slash128v6/DC31_CNet_Badge/Docs/Photos/IMG_1198.jpeg

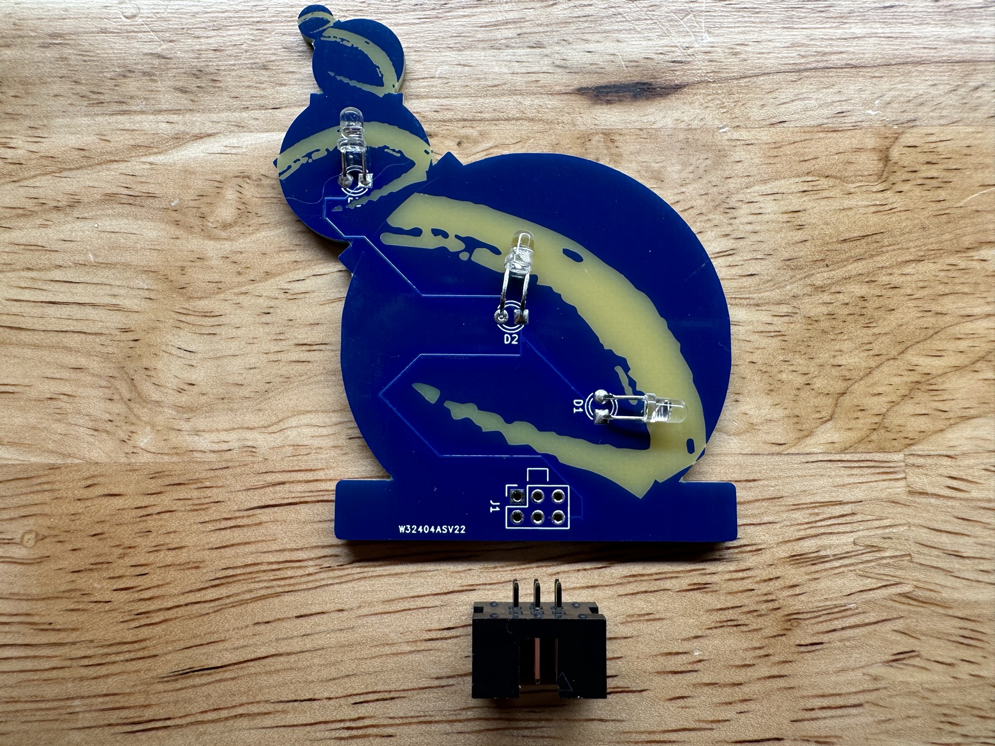
Docs/Photos/IMG_1198.jpeg
