slash128v6/DC31_CNet_Badge/Docs/Photos/Screenshot 2023-03-08 080836.png

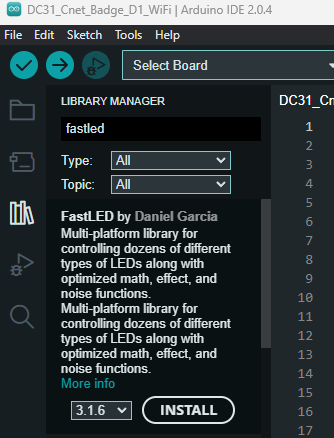
Docs/Photos/Screenshot 2023-03-08 080836.png
