slash128v6/DC31_CNet_Badge/Software/Wemos D1 Mini Info/Wemos Board Settings.png

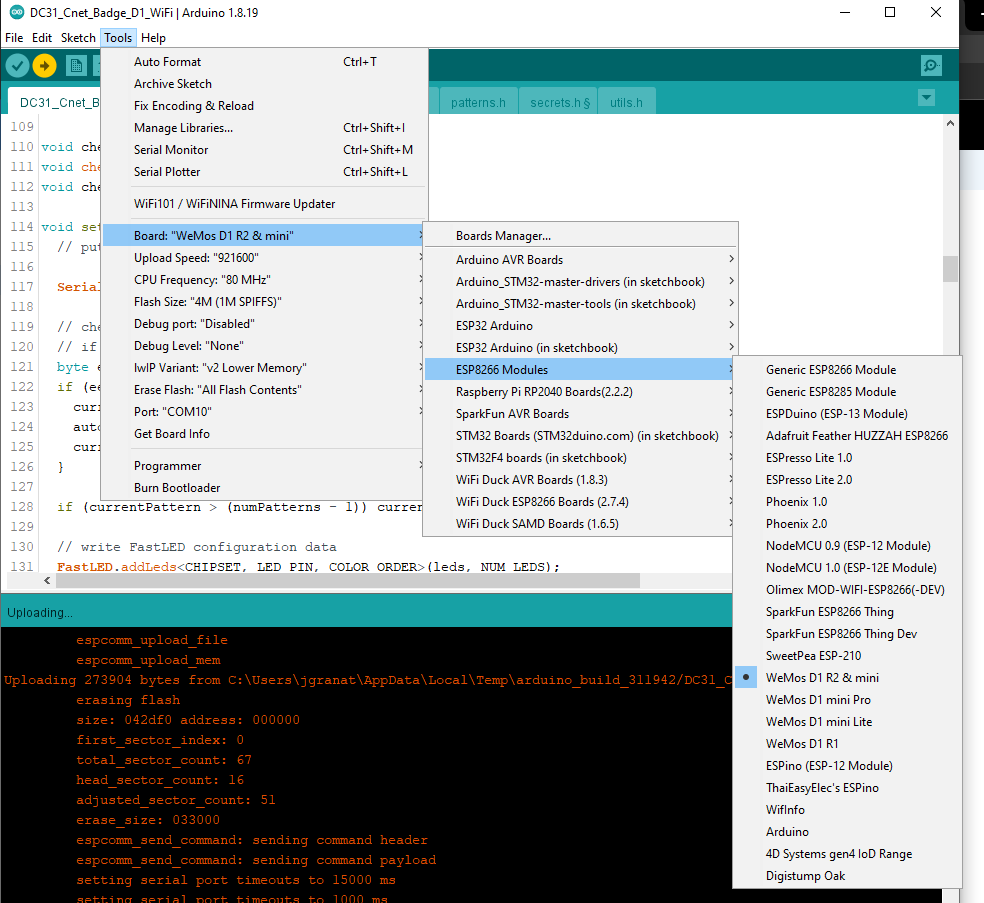
Software/Wemos D1 Mini Info/Wemos Board Settings.png
