slash128v6/DC31_CNet_Badge/Hardware/PCB Ordering Notes.txt

PCBWay.com Ordering

Front - 
0.8mm thickness
Blue soldermask
No silkscreen
No drills
No PCB ID

Rear - 
1.6mm thickness
Matte Black
No PCB ID
