slash128v6/DC31_CNet_Badge/Hardware/DC31_Cnet_Badge_Display_Stand/DC31_Cnet_Badge_Display_Stand-Body.stl

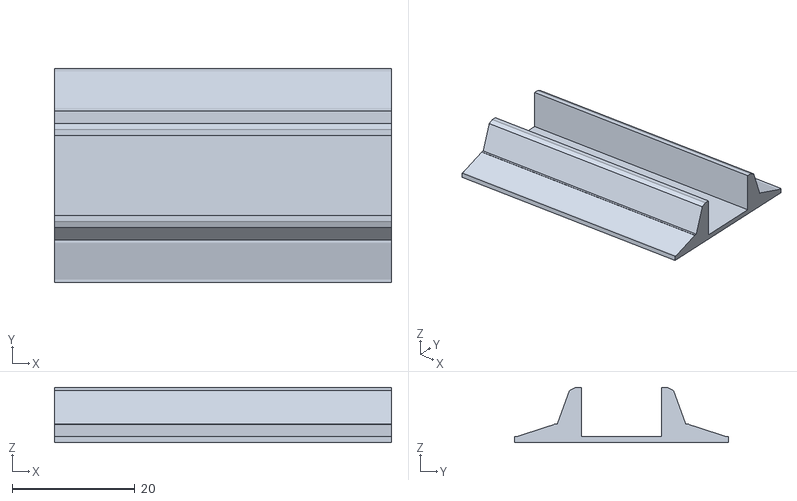
[picture p30: CAD file, 2023-06-28]
Hardware/DC31_Cnet_Badge_Display_Stand/DC31_Cnet_Badge_Display_Stand-Body.stl
55.0 x 35.0 x 9.00
