slash128v6/DC31_CNet_Badge/(list of files, cad)

Other CAD files:
Hardware/DC31_Cnet_Badge_Display_Stand/DC31_Cnet_Badge_Display_Stand.FCStd
Hardware/DC31_Cnet_Badge_Display_Stand/DC31_Cnet_Badge_Display_Stand.blend
