slash128v6/DC31_CNet_Badge/Software/Wemos D1 Mini Info/Wemos D1 Mini Pin Usage.png

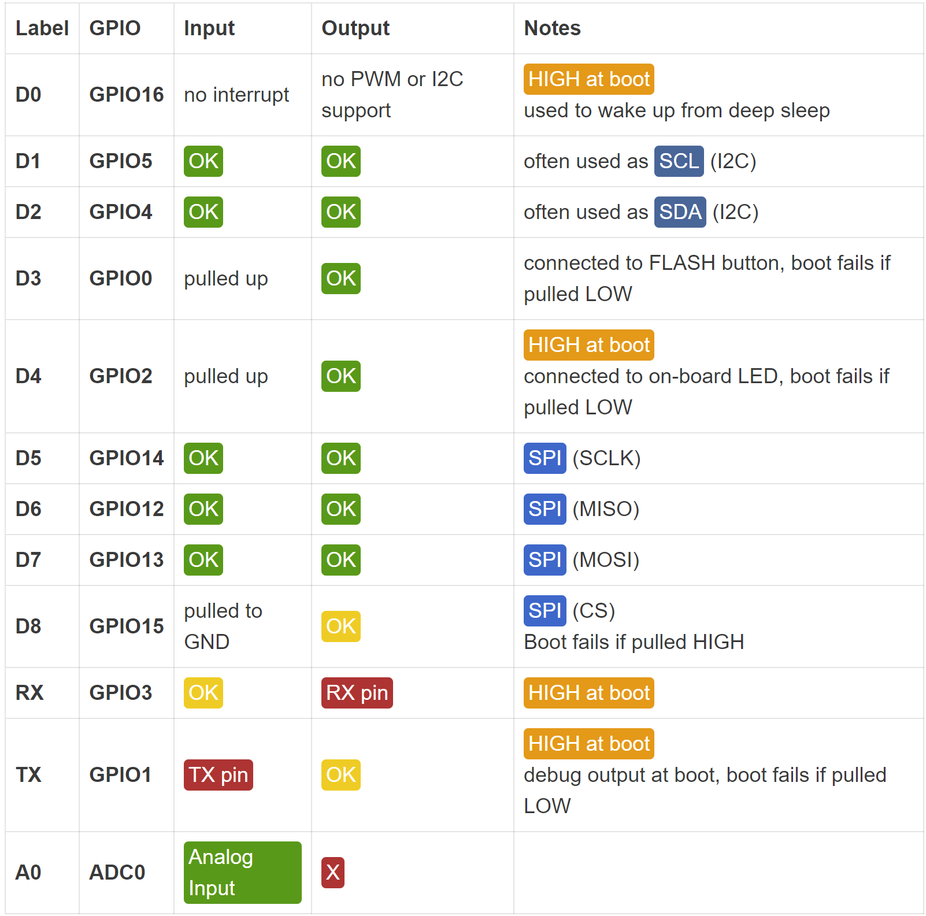
Software/Wemos D1 Mini Info/Wemos D1 Mini Pin Usage.png
