slash128v6/DC31_CNet_Badge/Hardware/DC31_Cnet_Badge_SAO/DC31_Cnet_Badge_SAO.kicad_pcb

## KiCad design Hardware/DC31_Cnet_Badge_SAO/DC31_Cnet_Badge_SAO.kicad_pcb (2023-06-05)

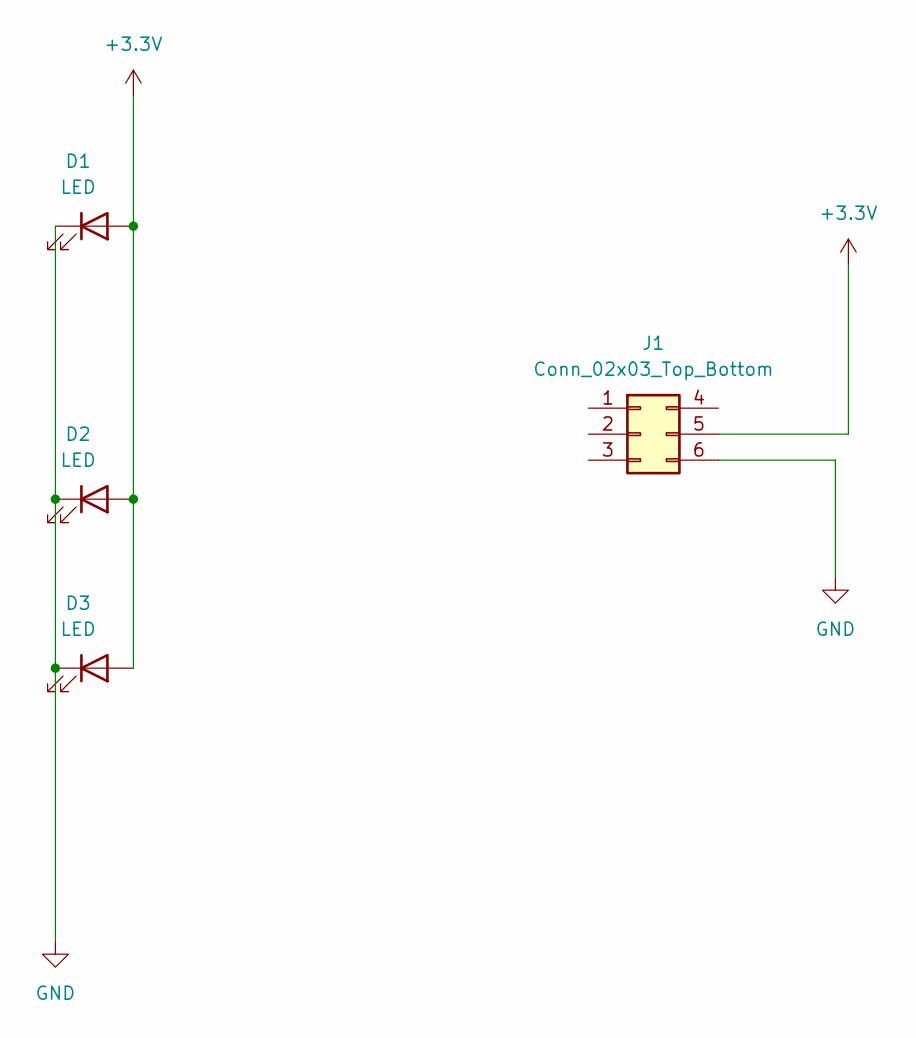
[picture p32: schematic DC31_Cnet_Badge_SAO.kicad_sch]

Parts:
D1, D2, D3: LED; LED_D3.0mm
J1: Conn_02x03_Top_Bottom; PinSocket_2x03_P2.54mm_Vertical_Tab

Connections:
+3.3V: D1.2 (A), D2.2 (A), D3.2 (A), J1.5
GND: D1.1 (K), D2.1 (K), D3.1 (K), J1.6

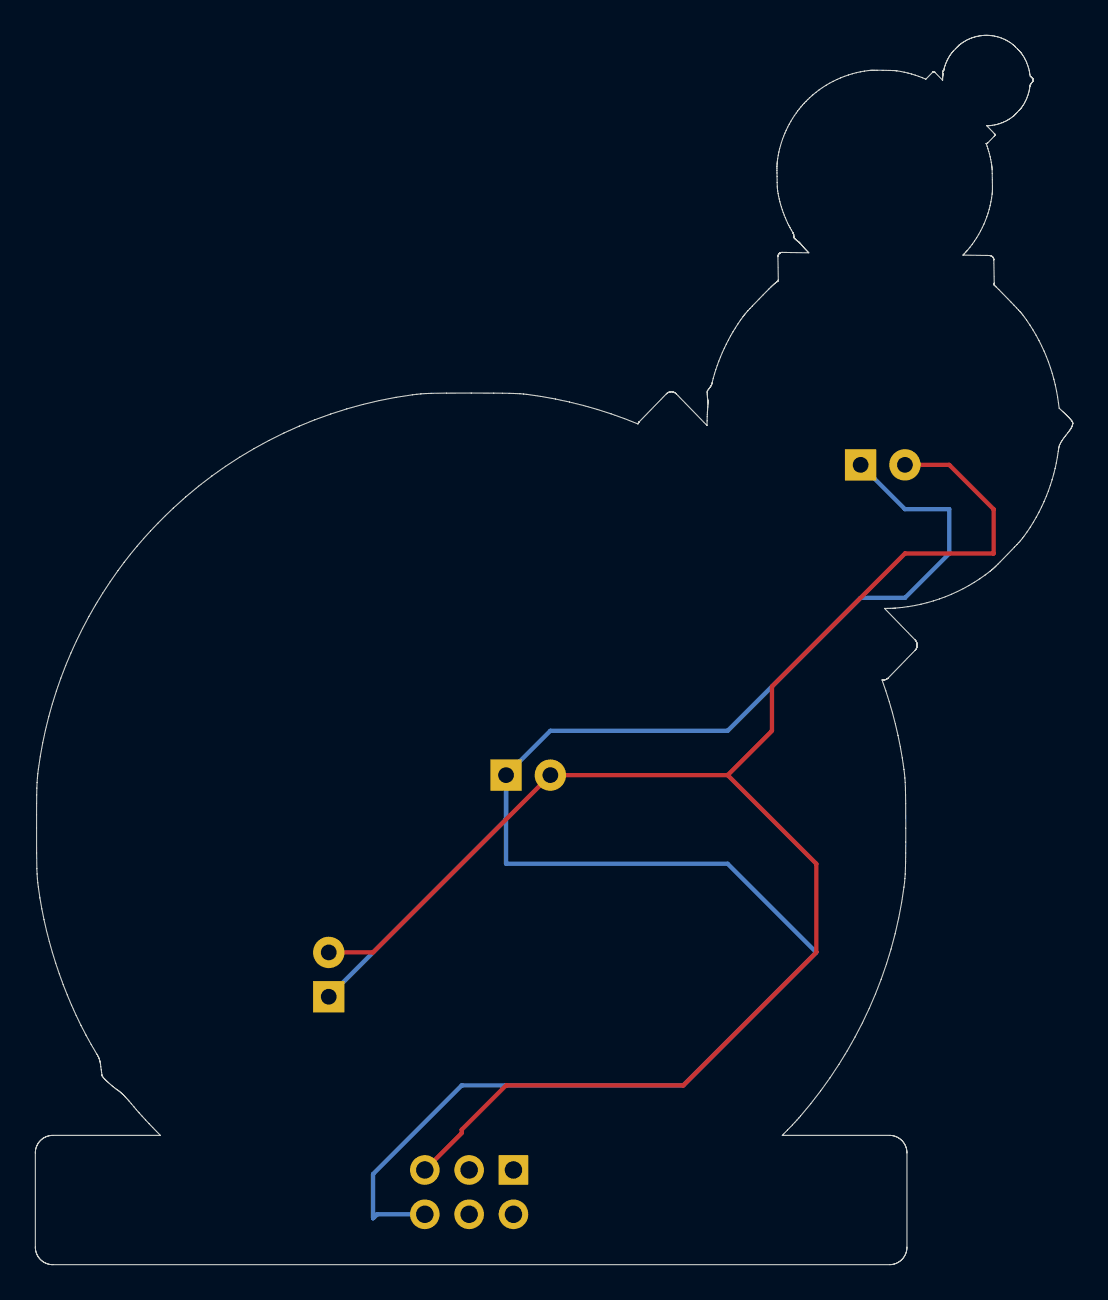
[picture p33: board DC31_Cnet_Badge_SAO.kicad_pcb from above]

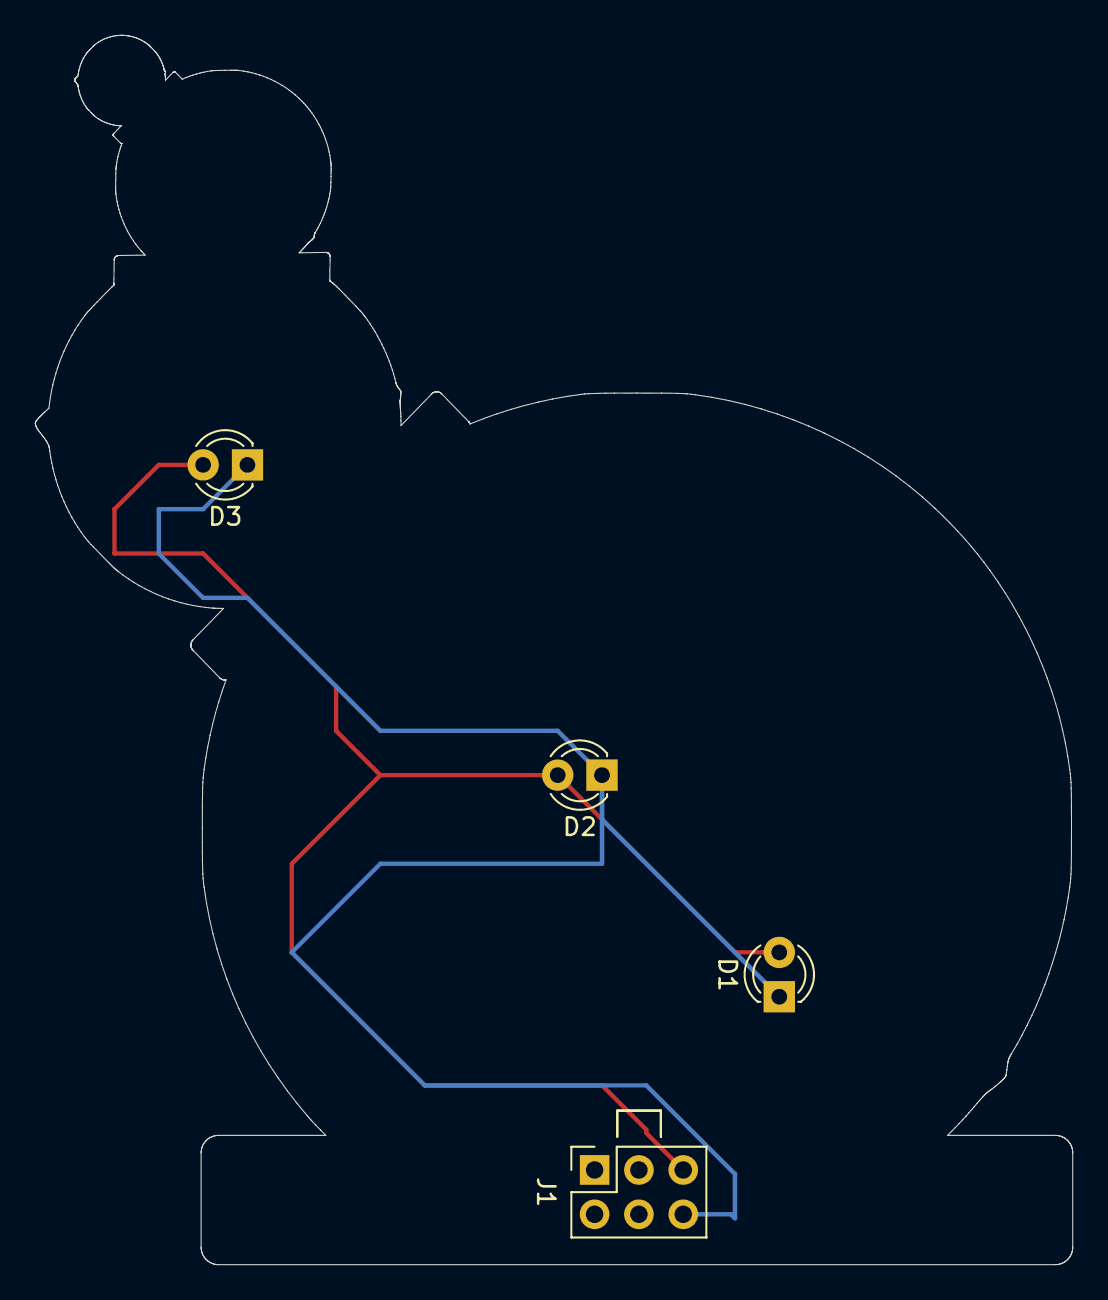
[picture p34: board DC31_Cnet_Badge_SAO.kicad_pcb from below]

Board: 2 copper layers, 59.5 x 70.5 mm, 4 parts (4 on the bottom side), 2 nets.
