slash128v6/DC31_CNet_Badge/Hardware/DC31_Cnet_Badge_Rear/DC31_Cnet_Badge_Rear.kicad_pcb

## KiCad design Hardware/DC31_Cnet_Badge_Rear/DC31_Cnet_Badge_Rear.kicad_pcb (2022-09-09)

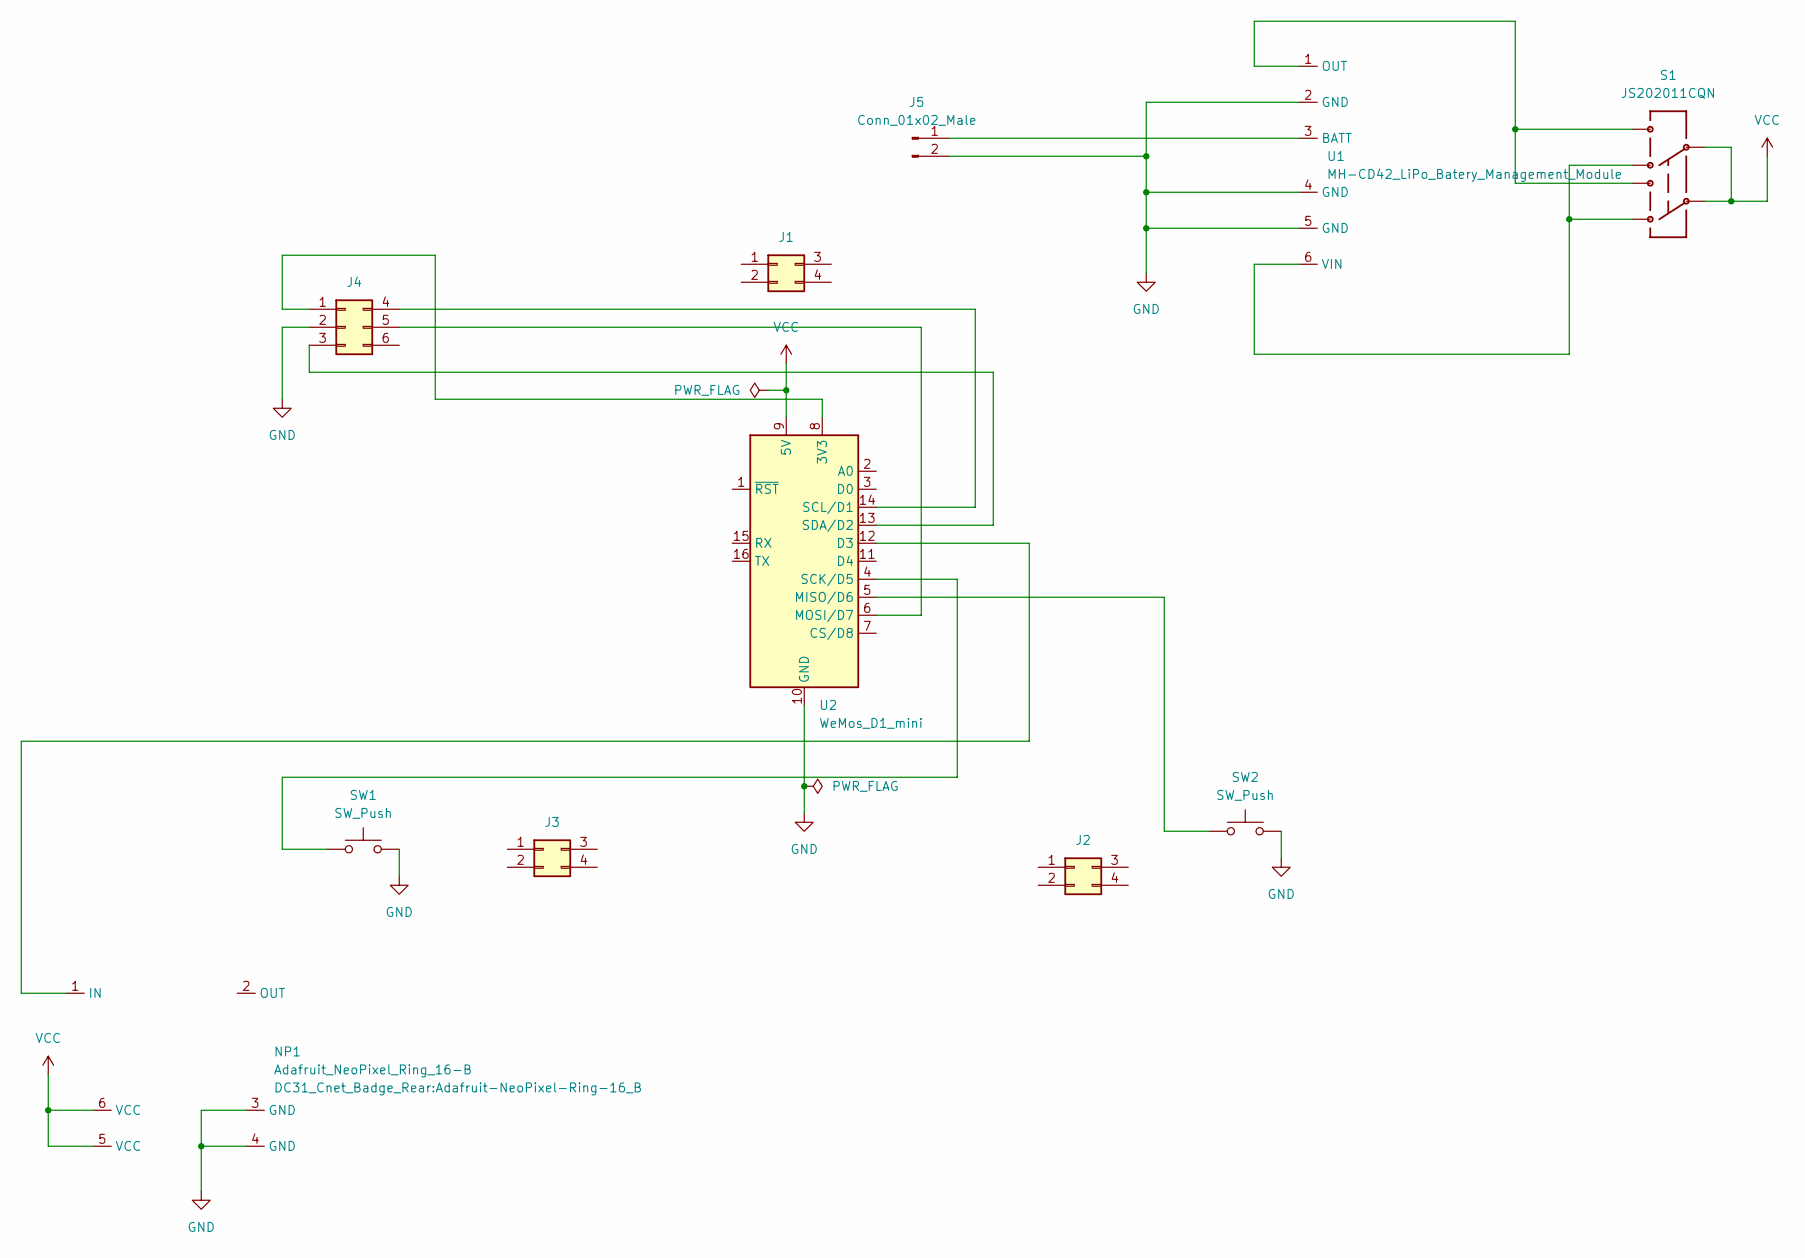
[picture p35: schematic DC31_Cnet_Badge_Rear.kicad_sch]

Parts:
J1, J2, J3: Conn_02x02_Top_Bottom; PinSocket_2x02_P2.54mm_Vertical
J4: Conn_02x03_Top_Bottom; PinSocket_2x03_P2.54mm_Vertical_Tab
J5: Conn_01x02_Male; JST_PH_S2B-PH-K_1x02_P2.00mm_Horizontal
NP1: Adafruit_NeoPixel_Ring_16-B; Adafruit-NeoPixel-Ring-16_B
S1: JS202011CQN; SPARKFUN-RETIRED_SWITCH-2.5X3.2-6
SW1, SW2: SW_Push; SW_PUSH_6mm
U1: MH-CD42_LiPo_Batery_Management_Module; MH-CD42 LiPo Battery Management Module Rear Charge LEDs
U2: WeMos_D1_mini; WEMOS_D1_mini_light

Connections:
GND: J4.2, J5.2, NP1.3 (GND), NP1.4 (GND), SW1.2, SW2.2, U1.2 (GND), U1.4 (GND), U1.5 (GND), U2.10 (GND)
unnamed: J4.1, U2.8 (3V3)
unnamed: J4.3, U2.13 (SDA/D2)
unnamed: J4.4, U2.14 (SCL/D1)
unnamed: J4.5, U2.6 (MOSI/D7)
unnamed: J5.1, U1.3 (BATT)
unnamed: NP1.1 (IN), U2.12 (D3)
unnamed: S1.1, S1.4, U1.6 (VIN)
unnamed: S1.3, S1.6, U1.1 (OUT)
unnamed: SW1.1, U2.4 (SCK/D5)
unnamed: SW2.1, U2.5 (MISO/D6)
VCC: NP1.5 (VCC), NP1.6 (VCC), S1.2, S1.5, U2.9 (5V)

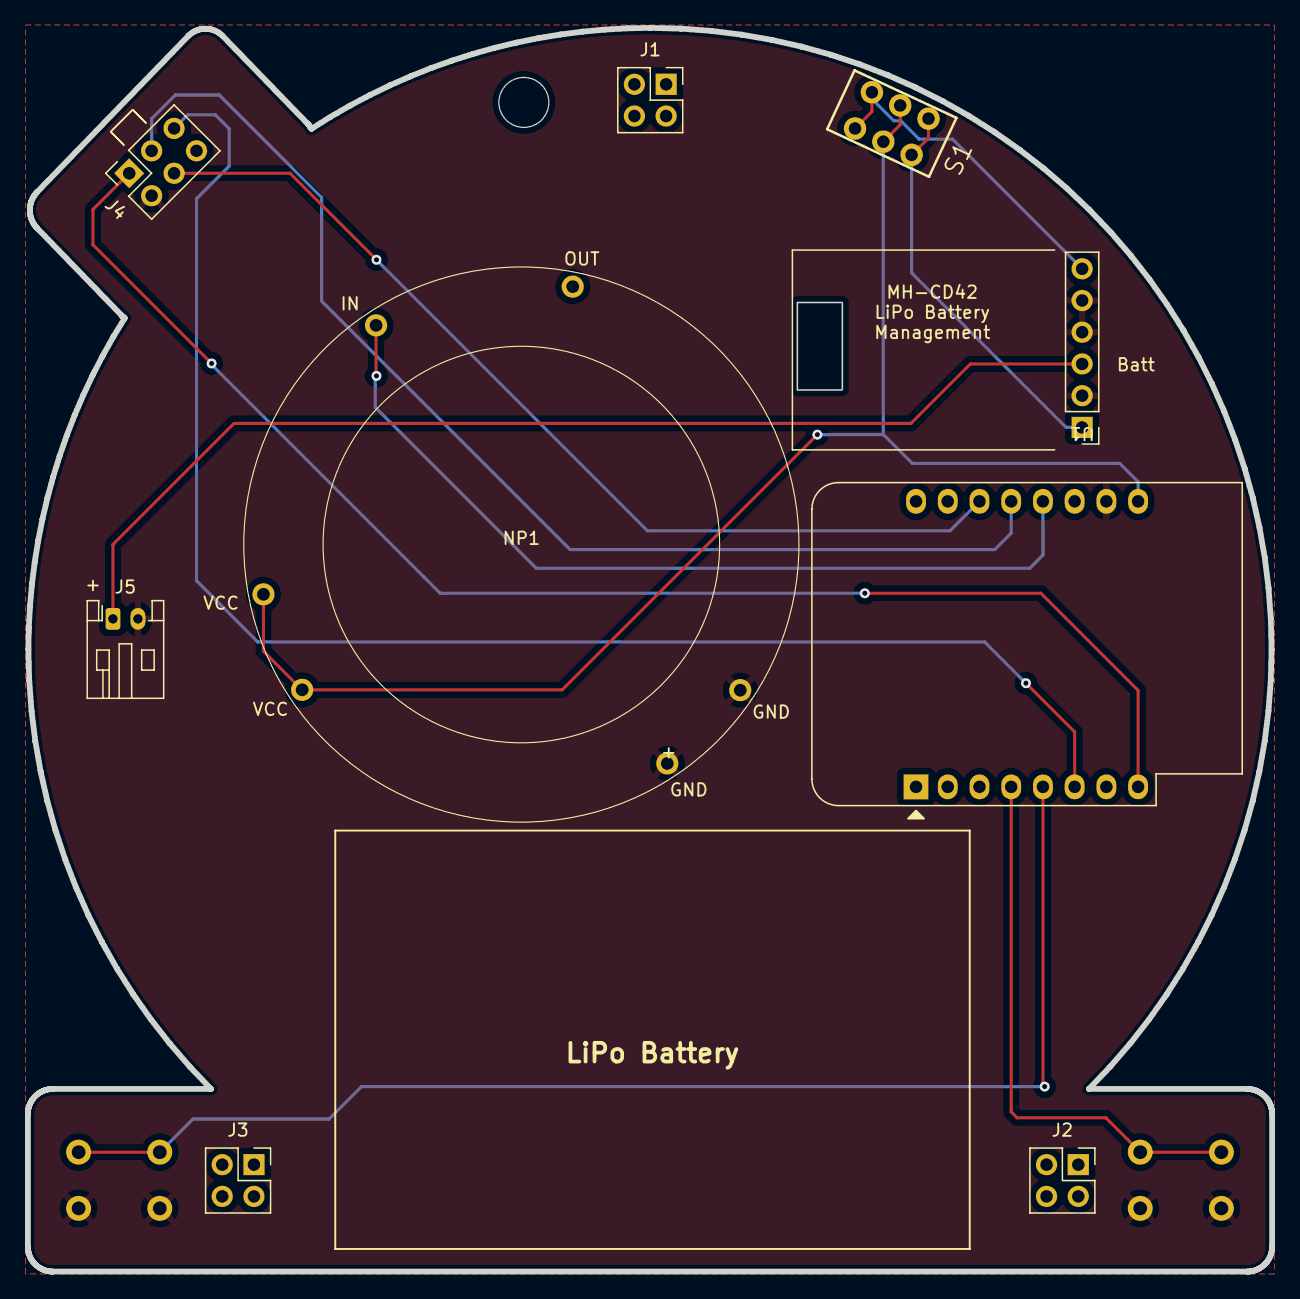
[picture p36: board DC31_Cnet_Badge_Rear.kicad_pcb from above]

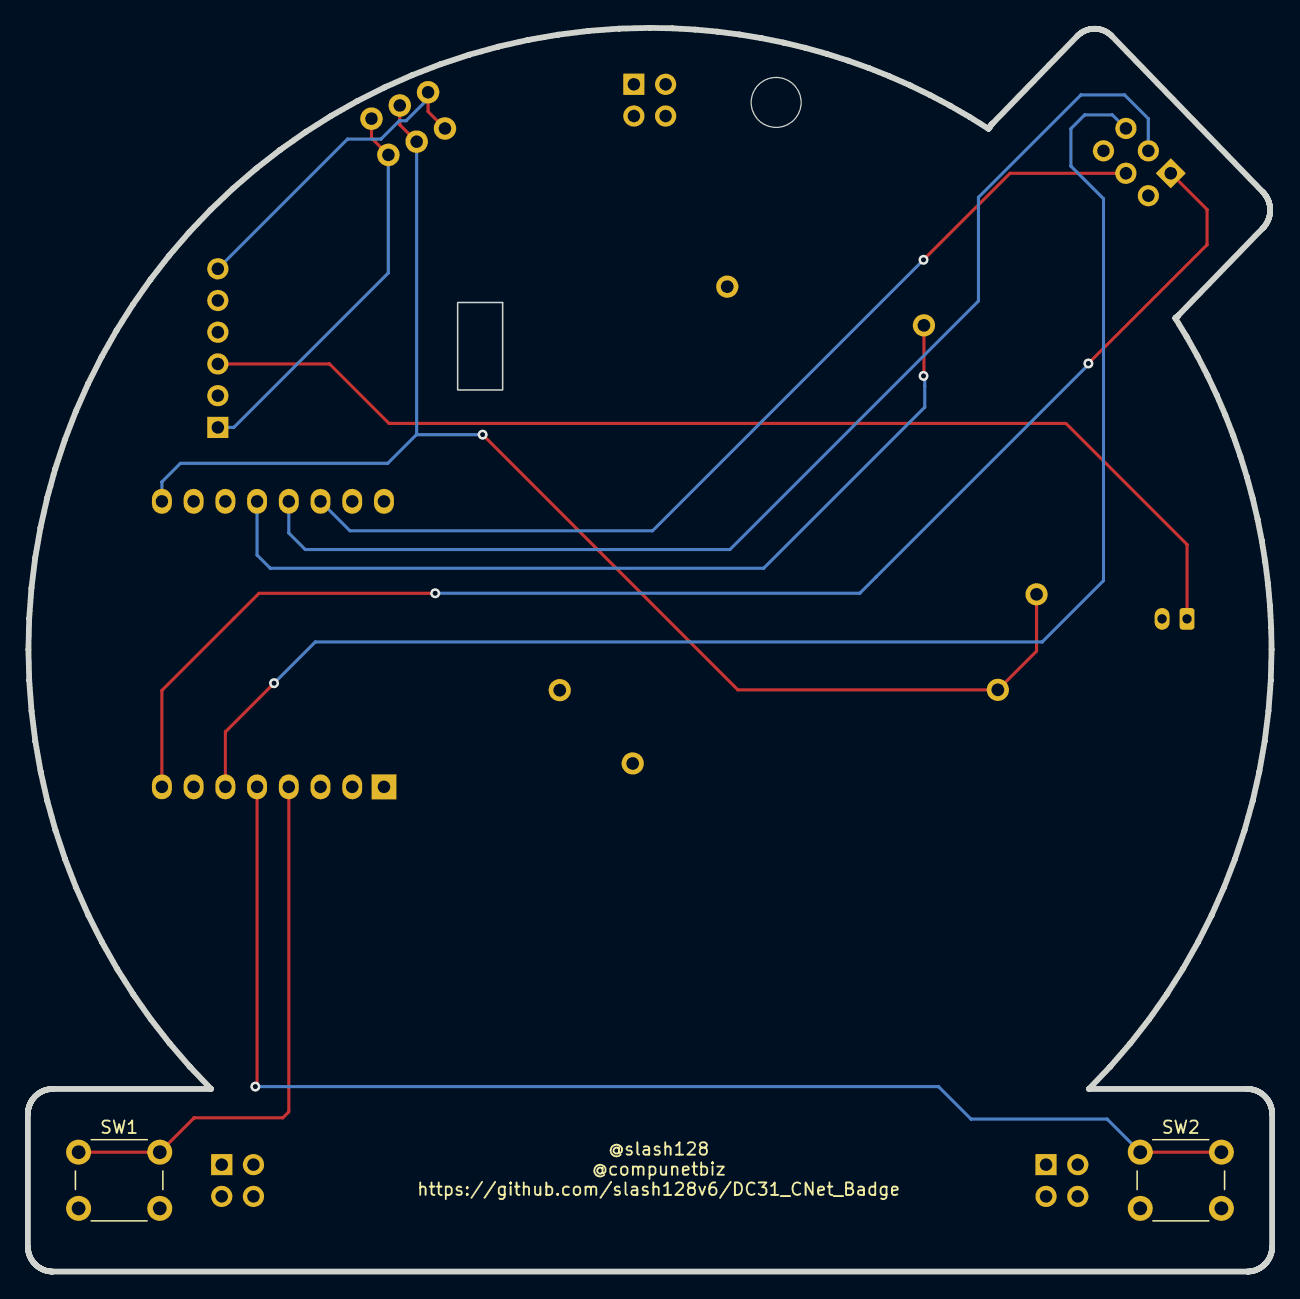
[picture p37: board DC31_Cnet_Badge_Rear.kicad_pcb from below]

Board: 2 copper layers, 99.6 x 99.6 mm, 11 parts (2 on the bottom side), 12 nets.
