slash128v6/DC31_CNet_Badge/Hardware/DC31_Cnet_Badge_Front/DC31_Cnet_Badge_Front.kicad_pcb

## KiCad design Hardware/DC31_Cnet_Badge_Front/DC31_Cnet_Badge_Front.kicad_pcb (2022-09-20)

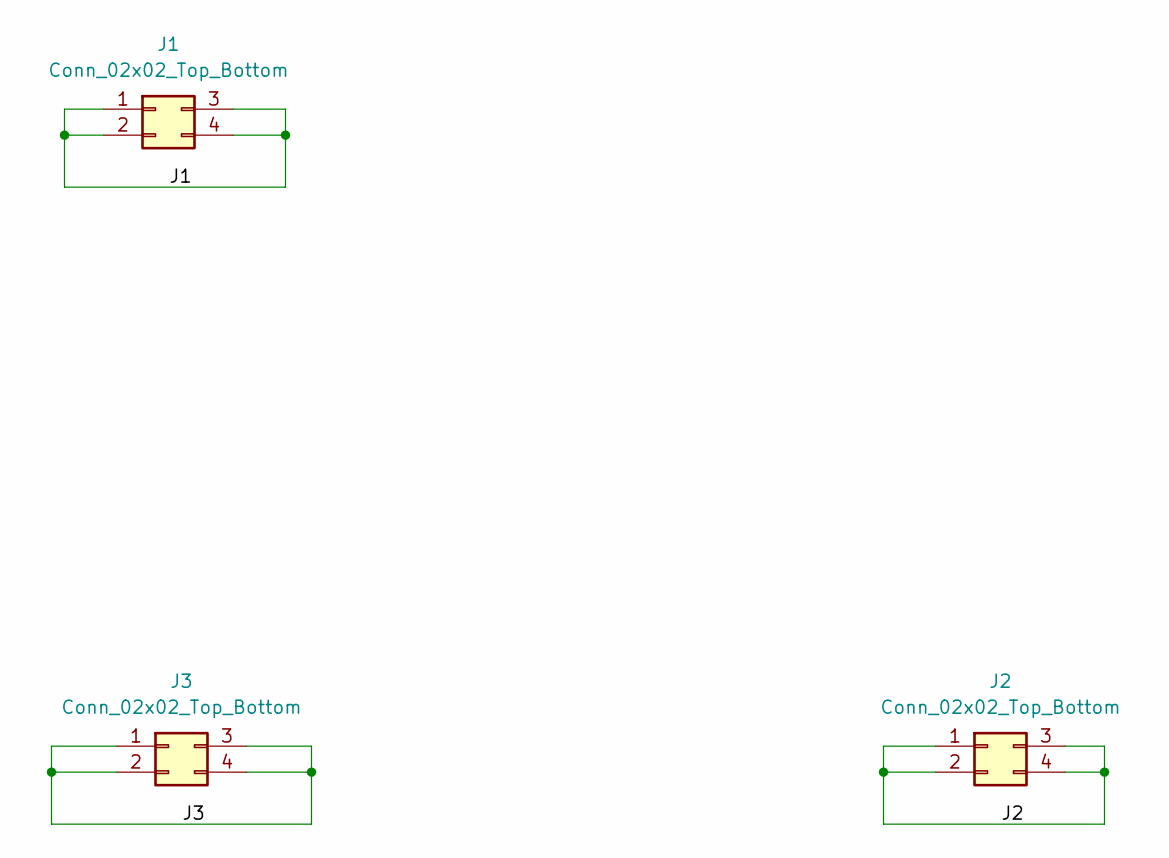
[picture p38: schematic DC31_Cnet_Badge_Front.kicad_sch]

Parts:
J1, J2, J3: Conn_02x02_Top_Bottom; PinHeader_2x02_P2.54mm_Vertical_SMD

Connections:
/J1: J1.1, J1.2, J1.3, J1.4
/J2: J2.1, J2.2, J2.3, J2.4
/J3: J3.1, J3.2, J3.3, J3.4

Board: 2 copper layers, 3 parts (3 on the bottom side), 3 nets, no tracks yet.
