slash128v6/DC31_CNet_Badge/Software/DC31_Cnet_Badge_D1_WiFi/input.h

// Process input

#define NUMBUTTONS 2
#define MODEBUTTON D5
#define BRIGHTNESSBUTTON D6

#define BTNIDLE 0
#define BTNDEBOUNCING 1
#define BTNPRESSED 2
#define BTNRELEASED 3
#define BTNLONGPRESS 4
#define BTNLONGPRESSREAD 5

#define BTNDEBOUNCETIME 20
#define BTNLONGPRESSTIME 1000

unsigned long buttonEvents[NUMBUTTONS];
byte buttonStatuses[NUMBUTTONS];
byte buttonmap[NUMBUTTONS] = {MODEBUTTON, BRIGHTNESSBUTTON};

void updateButtons() {
  for (byte i = 0; i < NUMBUTTONS; i++) {
    switch (buttonStatuses[i]) {
      case BTNIDLE:
        if (digitalRead(buttonmap[i]) == LOW) {
          buttonEvents[i] = currentMillis;
          buttonStatuses[i] = BTNDEBOUNCING;
        }
        break;

      case BTNDEBOUNCING:
        if (currentMillis - buttonEvents[i] > BTNDEBOUNCETIME) {
          if (digitalRead(buttonmap[i]) == LOW) {
            buttonStatuses[i] = BTNPRESSED;
          }
        }
        break;

      case BTNPRESSED:
        if (digitalRead(buttonmap[i]) == HIGH) {
          buttonStatuses[i] = BTNRELEASED;
        } else if (currentMillis - buttonEvents[i] > BTNLONGPRESSTIME) {
          buttonStatuses[i] = BTNLONGPRESS;
        }
        break;

      case BTNRELEASED:
        break;

      case BTNLONGPRESS:
        break;

      case BTNLONGPRESSREAD:
        if (digitalRead(buttonmap[i]) == HIGH) {
          buttonStatuses[i] = BTNIDLE;
        }
        break;
    }
  }
}

byte buttonStatus(byte buttonNum) {

  byte tempStatus = buttonStatuses[buttonNum];
  if (tempStatus == BTNRELEASED) {
    buttonStatuses[buttonNum] = BTNIDLE;
  } else if (tempStatus == BTNLONGPRESS) {
    buttonStatuses[buttonNum] = BTNLONGPRESSREAD;
  }

  return tempStatus;

}

void doButtons() {
  
  // Check the mode button (for switching between effects)
  switch (buttonStatus(0)) {

    case BTNRELEASED: // button was pressed and released quickly
      cycleMillis = currentMillis;
      if (++currentPattern >= numPatterns) currentPattern = 0; // loop to start of effect list
      effectInit = false; // trigger effect initialization when new effect is selected
      eepromMillis = currentMillis;
      eepromOutdated = true;
      break;

    case BTNLONGPRESS: // button was held down for a while
      autoCycle = !autoCycle; // toggle auto cycle mode
      confirmBlink(); // two green blink: auto mode. two red blinks: manual mode.
      eepromMillis = currentMillis;
      eepromOutdated = true;
      break;

  }

  // Check the brightness adjust button
  switch (buttonStatus(1)) {

    case BTNRELEASED: // button was pressed and released quickly
      currentBrightness += 51; // increase the brightness (wraps to lowest)
      FastLED.setBrightness(scale8(currentBrightness, MAXBRIGHTNESS));
      eepromMillis = currentMillis;
      eepromOutdated = true;
      break;

    case BTNLONGPRESS: // button was held down for a while
      currentBrightness = STARTBRIGHTNESS; // reset brightness to startup value
      FastLED.setBrightness(scale8(currentBrightness, MAXBRIGHTNESS));
      eepromMillis = currentMillis;
      eepromOutdated = true;
      break;

  }

}
